GAULAvionique/Station-au-sol-PCBv2/SAS_PCBv2/SAS_PCBv2.kicad_pcb

## KiCad design SAS_PCBv2/SAS_PCBv2.kicad_pcb (2026-07-17)

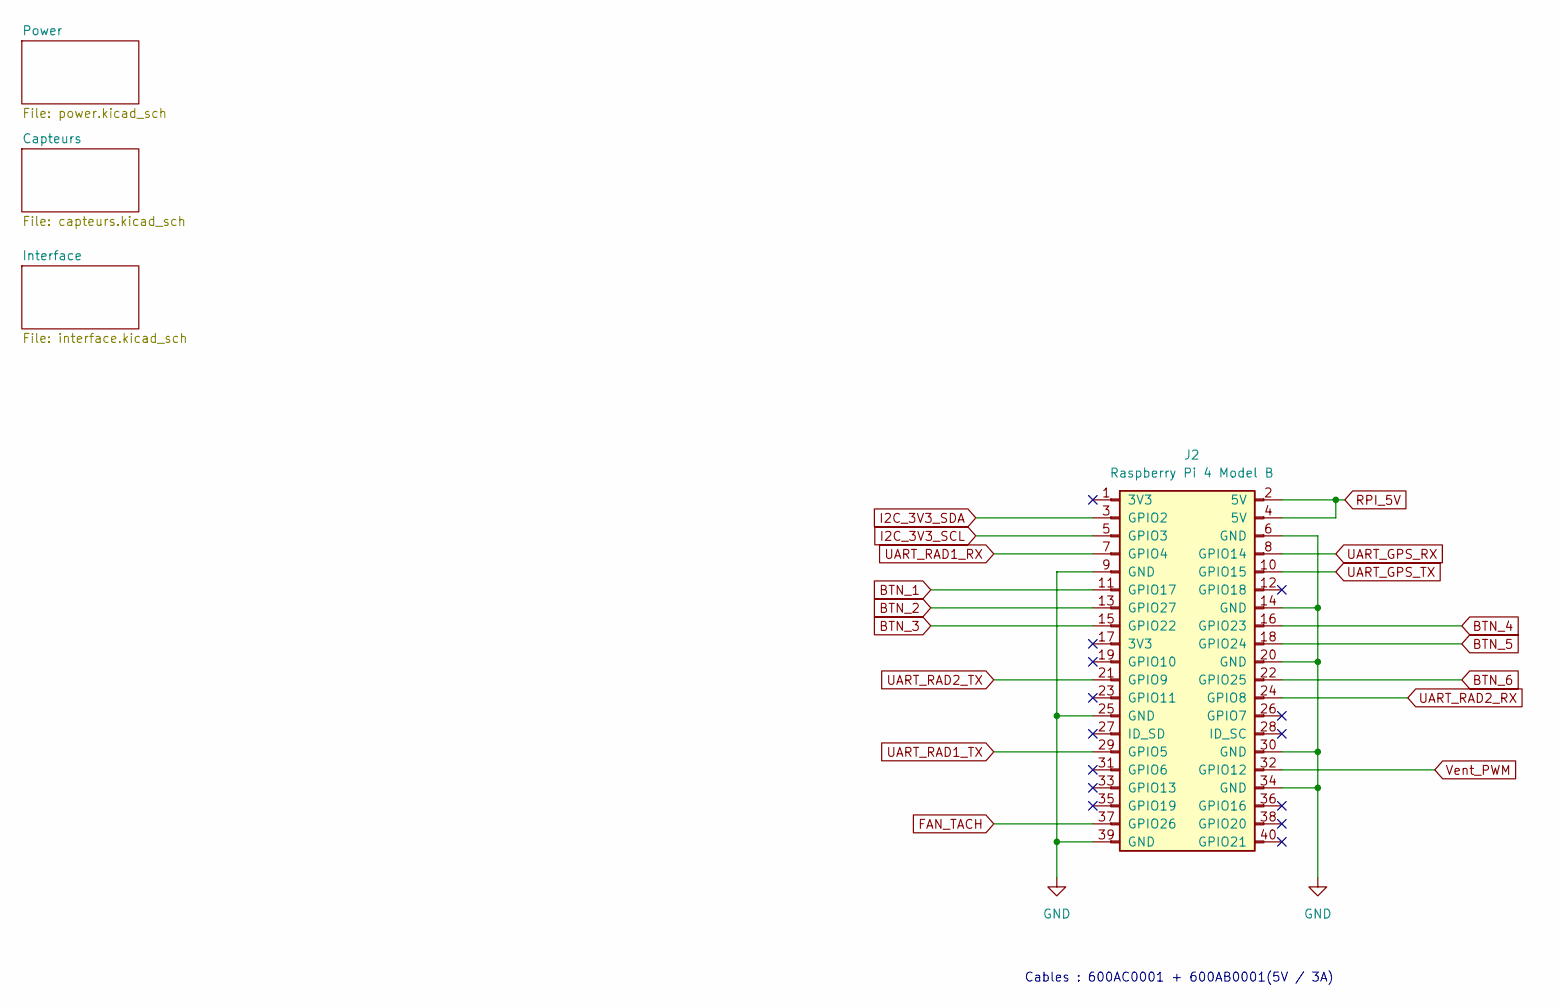
[picture p1: schematic SAS_PCBv2.kicad_sch]

Parts:
J2: Raspberry Pi 4 Model B; PinSocket_2x20_P2.54mm_Vertical

Connections:
BTN_1: J2.11 (GPIO17); also elsewhere on the board
BTN_2: J2.13 (GPIO27); also elsewhere on the board
BTN_3: J2.15 (GPIO22); also elsewhere on the board
BTN_4: J2.16 (GPIO23); also elsewhere on the board
BTN_5: J2.18 (GPIO24); also elsewhere on the board
BTN_6: J2.22 (GPIO25); also elsewhere on the board
FAN_TACH: J2.37 (GPIO26); also elsewhere on the board
GND: J2.6 (GND), J2.9 (GND), J2.14 (GND), J2.20 (GND), J2.25 (GND), J2.30 (GND), J2.34 (GND), J2.39 (GND); also elsewhere on the board
I2C_3V3_SCL: J2.5 (GPIO3); also elsewhere on the board
I2C_3V3_SDA: J2.3 (GPIO2); also elsewhere on the board
RPI_5V: J2.2 (5V), J2.4 (5V); also elsewhere on the board
UART_GPS_RX: J2.8 (GPIO14); also elsewhere on the board
UART_GPS_TX: J2.10 (GPIO15); also elsewhere on the board
UART_RAD1_RX: J2.7 (GPIO4); also elsewhere on the board
UART_RAD1_TX: J2.29 (GPIO5); also elsewhere on the board
UART_RAD2_RX: J2.24 (GPIO8); also elsewhere on the board
UART_RAD2_TX: J2.21 (GPIO9); also elsewhere on the board
Vent_PWM: J2.32 (GPIO12); also elsewhere on the board

Notes on the sheet:
Cables : 600AC0001 + 600AB0001(5V / 3A)

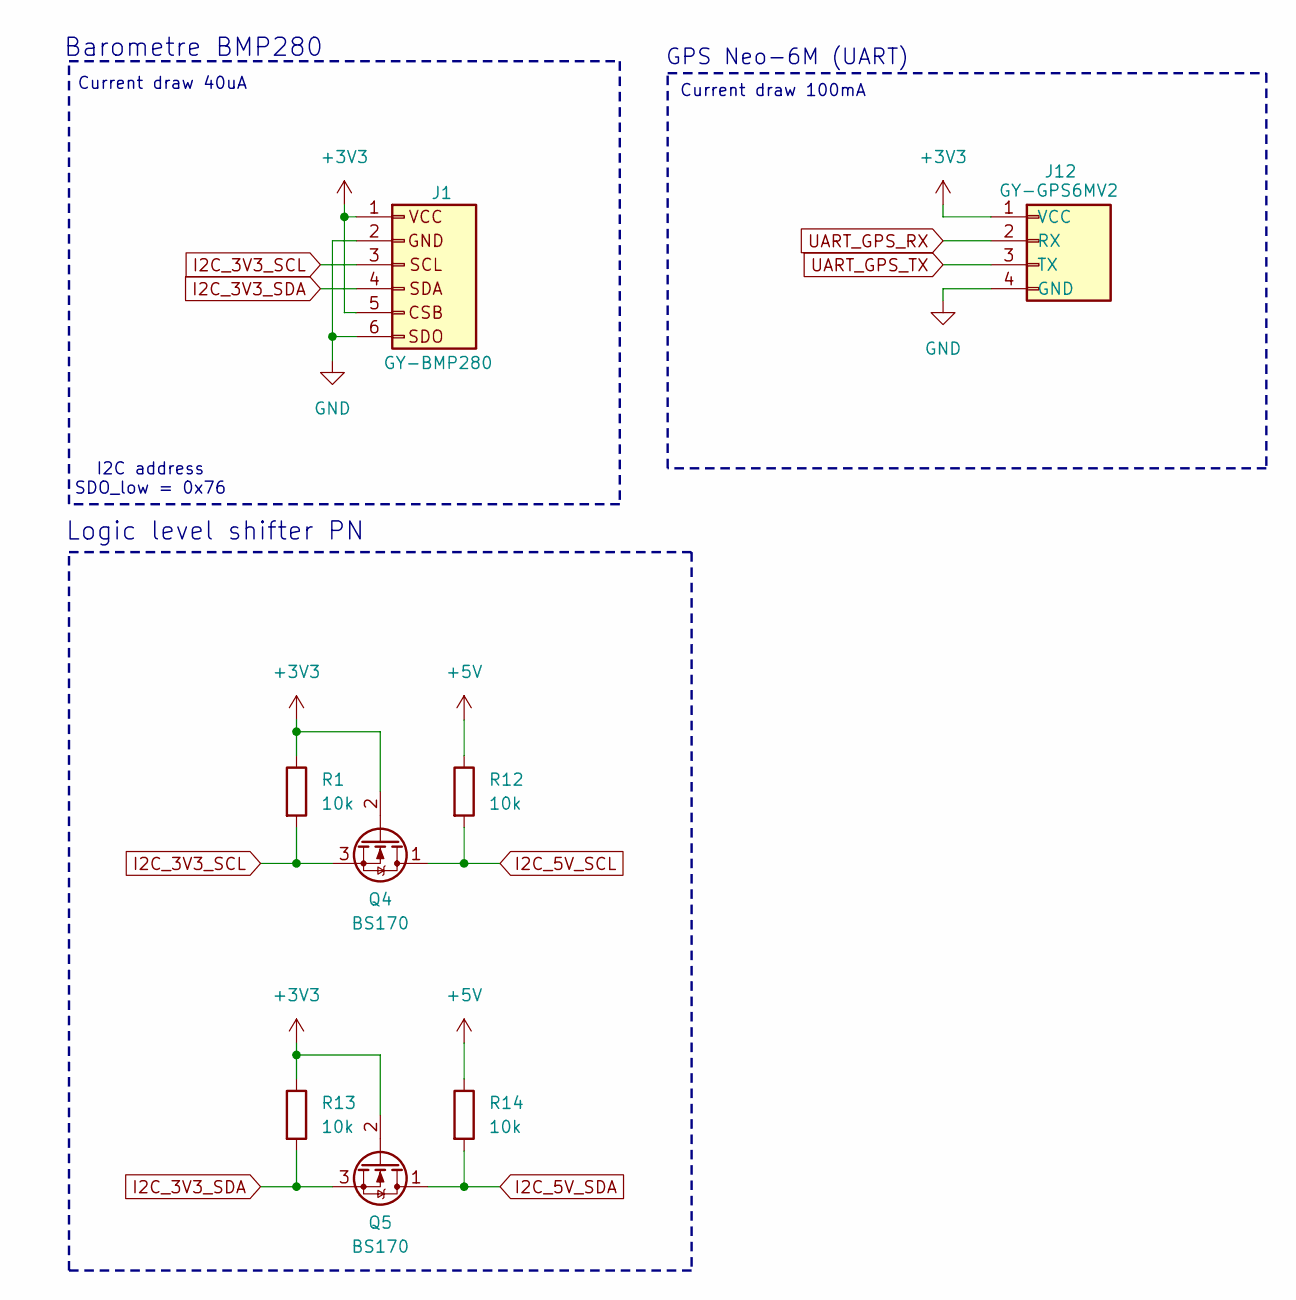
[picture p2: schematic capteurs.kicad_sch]

Parts:
J1: GY-BMP280; PinHeader_1x06_P2.54mm_Vertical
J12: GY-GPS6MV2; PinHeader_1x04_P2.54mm_Vertical
Q4, Q5: BS170; TO-92_Inline
R1, R12, R13, R14: 10k; R_Axial_DIN0207_L6.3mm_D2.5mm_P10.16mm_Horizontal; Digikey MFR-25FRF52-10K

Connections:
+3V3: J1.1 (Vcc), J1.5, J12.1 (VCC), Q4.2 (G), Q5.2 (G), R1.1, R13.1; also elsewhere on the board
+5V: R12.1, R14.1; also elsewhere on the board
GND: J1.2, J1.6, J12.4 (GND); also elsewhere on the board
I2C_3V3_SCL: J1.3, Q4.3 (S), R1.2; also elsewhere on the board
I2C_3V3_SDA: J1.4, Q5.3 (S), R13.2; also elsewhere on the board
I2C_5V_SCL: Q4.1 (D), R12.2; also elsewhere on the board
I2C_5V_SDA: Q5.1 (D), R14.2; also elsewhere on the board
UART_GPS_RX: J12.2 (RX); also elsewhere on the board
UART_GPS_TX: J12.3 (TX); also elsewhere on the board

Notes on the sheet:
Current draw 40uA
Logic level shifter PN
GPS Neo-6M (UART)
I2C address SDO_low = 0x76
Barometre BMP280
Current draw 100mA

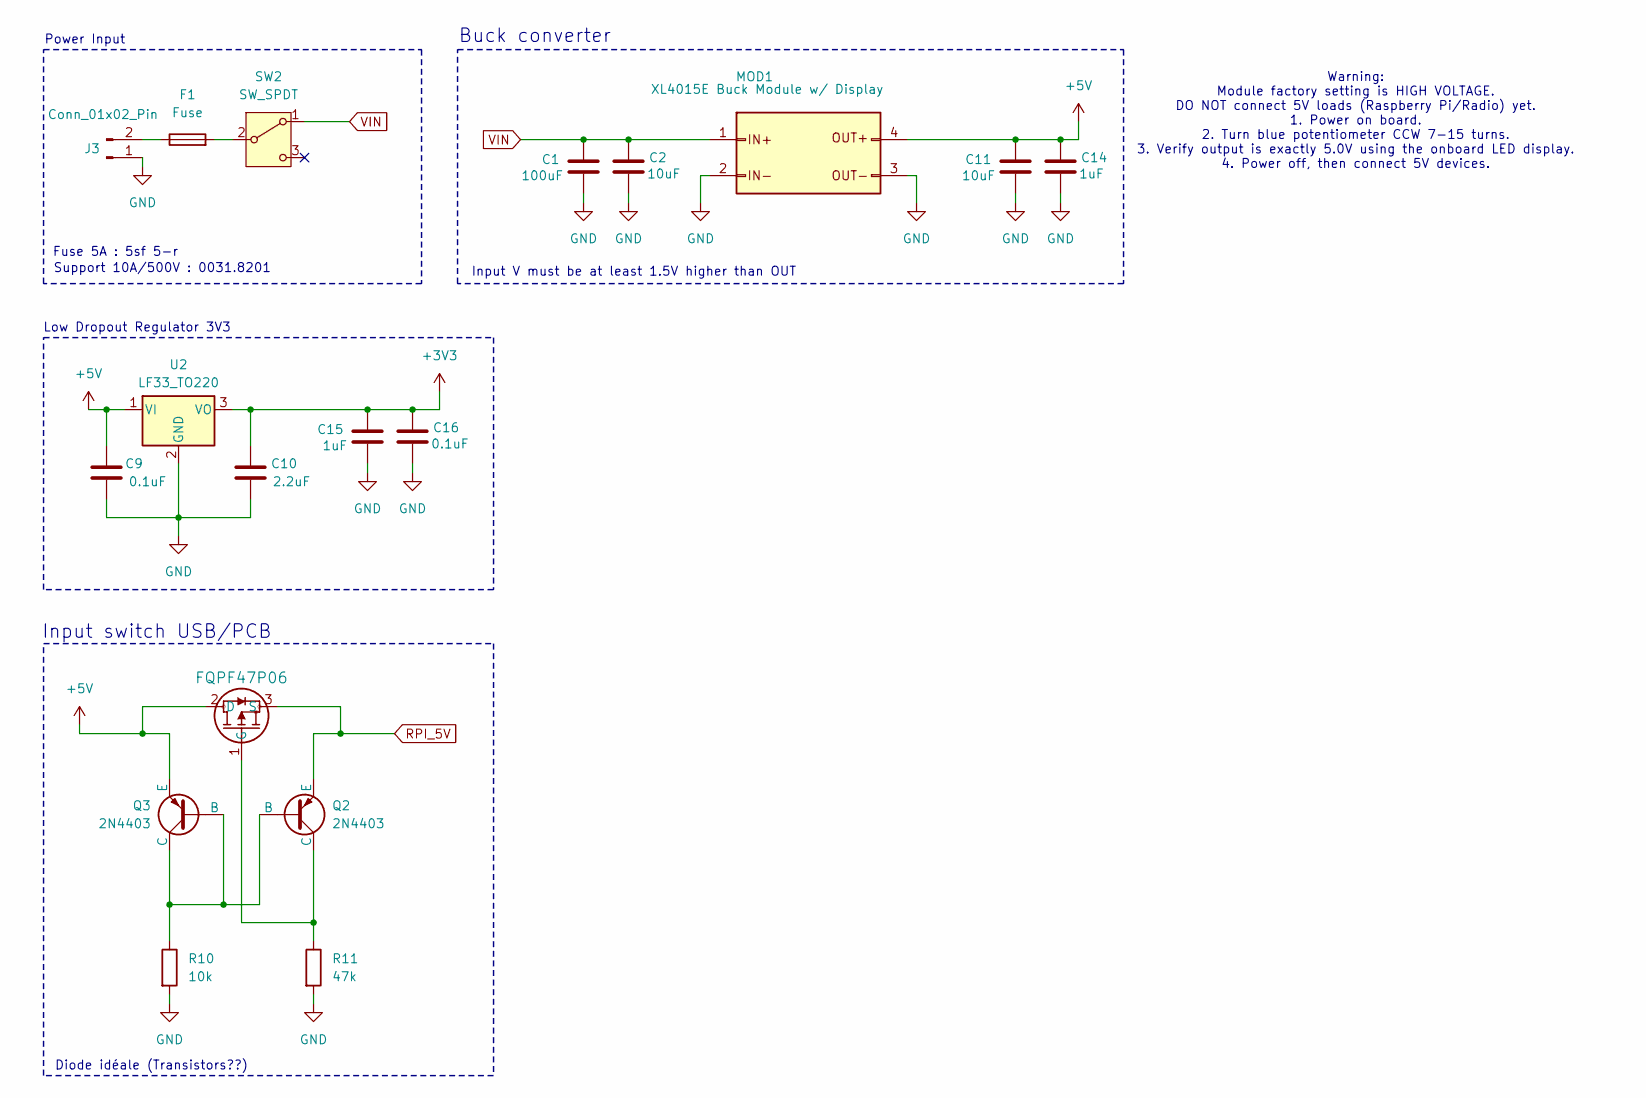
[picture p3: schematic power.kicad_sch]

Parts:
C1: 100uF; CAP_RR71_NIC
C2, C11: 10uF; CP_Radial_D5.0mm_P2.00mm; Digikey 1189-2322-ND
C9, C16: 0.1uF; CAP_C320_KEM
C10: 2.2uF; CAP_FG14_TDK
C14, C15: 1uF; CP_Radial_D5.0mm_P2.00mm
F1: Fuse; Fuseholder_Cylinder-5x20mm_Schurter_0031_8201_Horizontal_Op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
J3: Conn_01x02_Pin; AMASS_XT30U-M_1x02_P5.0mm_Vertical
MOD1: XL4015E Buck Module w/ Display; XL4015E_Buck_Module_68x38mm(1)
MOSFET1: FQPF47P06; PMOS_FQP_ONS
Q2, Q3: 2N4403; PBIP_2N4403_DIO
R10: 10k; R_Axial_DIN0207_L6.3mm_D2.5mm_P10.16mm_Horizontal; Digikey MFR-25FRF52-10K
R11: 47k; R_Axial_DIN0207_L6.3mm_D2.5mm_P10.16mm_Horizontal; Digikey MFR-25FRF52-47K
SW2: SW_SPDT; SW_ANT1_CRS
U2: LF33_TO220; TO-220-3_Vertical

Connections:
+3V3: C10.1, C15.1, C16.1, U2.3 (VO); also elsewhere on the board
+5V: C9.1, C11.1, C14.1, MOD1.4 (OUT+), MOSFET1.2 (D), Q3.1 (E), U2.1 (VI); also elsewhere on the board
GND: C1.2, C2.2, C9.2, C10.2, C11.2, C14.2, C15.2, C16.2, J3.1, MOD1.2 (IN-), MOD1.3 (OUT-), R10.2, R11.2, U2.2 (GND); also elsewhere on the board
unnamed: F1.1, J3.2
unnamed: MOSFET1.1 (G), Q2.3 (C), R11.1
unnamed: Q2.2 (B), Q3.2 (B), Q3.3 (C), R10.1
unnamed: F1.2, SW2.2 (B)
RPI_5V: MOSFET1.3 (S), Q2.1 (E); also elsewhere on the board
VIN: C1.1, C2.1, MOD1.1 (IN+), SW2.1 (A)

Notes on the sheet:
Fuse 5A : 5sf 5-r
Low Dropout Regulator 3V3
Support 10A/500V : 0031.8201
Diode idéale (Transistors??)
Input switch USB/PCB
Input V must be at least 1.5V higher than OUT
Power Input
Buck converter
Warning: Module factory setting is HIGH VOLTAGE. DO NOT connect 5V loads (Raspberry Pi/Radio) yet. 1. Power on board. 2. Turn blue potentiometer CCW 7-15 turns. 3. Verify output is exactly 5.0V using the onboard LED display. 4. Power off, then connect 5V devices.

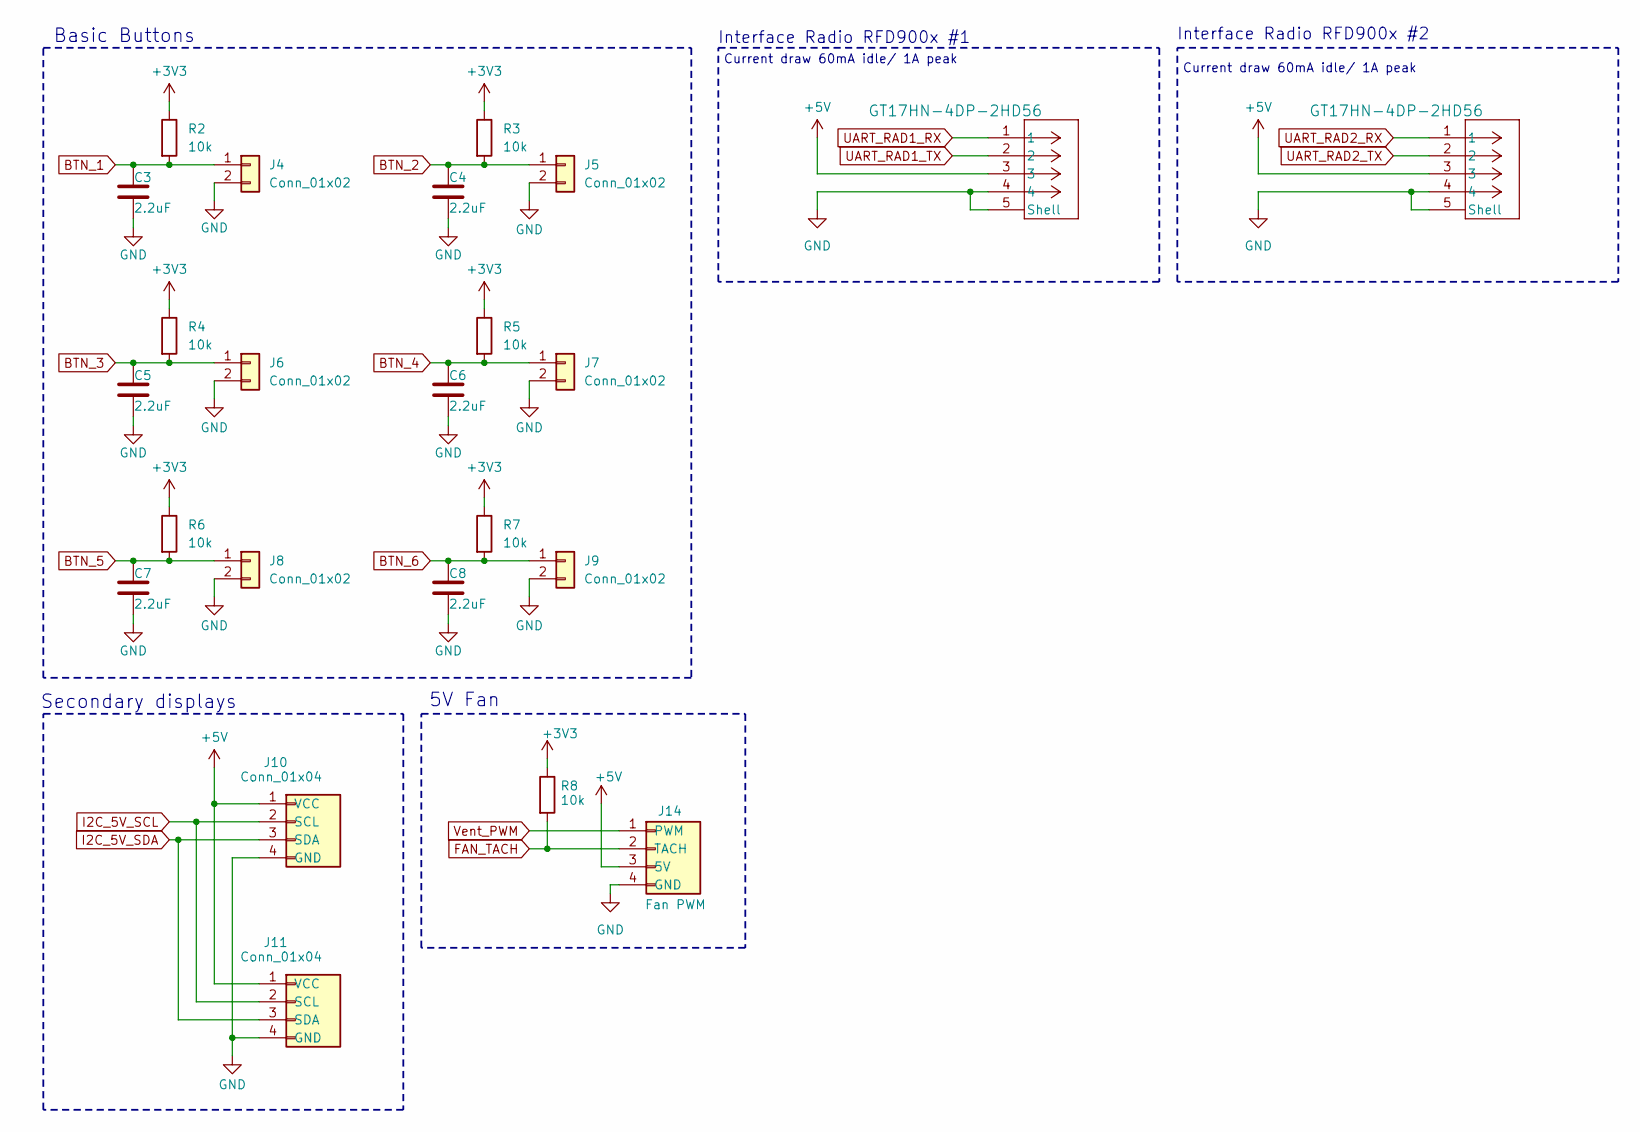
[picture p4: schematic interface.kicad_sch]

Parts:
C3, C4, C5, C6, C7, C8: 2.2uF; CAP_FG14_TDK
J4, J5, J6, J7, J8, J9: Conn_01x02; PinHeader_1x02_P2.54mm_Vertical
J10, J11: Conn_01x04; PinHeader_1x04_P2.54mm_Vertical
J14: Fan PWM; PinHeader_1x04_P2.54mm_Vertical
J16, J17: GT17HN-4DP-2HD56; CONN4_GT17HN_HIR; Manufacturer_Part_Number GT17HN-4DP-2H(D)(56); DigiKey_Part_Number 26-GT17HN-4DP-2H(D)(56)-ND
R2, R3, R4, R5, R6, R7, R8: 10k; R_Axial_DIN0207_L6.3mm_D2.5mm_P10.16mm_Horizontal; Digikey MFR-25FRF52-10K

Connections:
+3V3: R2.1, R3.1, R4.1, R5.1, R6.1, R7.1, R8.1; also elsewhere on the board
+5V: J10.1 (VCC), J11.1 (VCC), J14.3 (5V), J16.3, J17.3; also elsewhere on the board
BTN_1: C3.1, J4.1, R2.2; also elsewhere on the board
BTN_2: C4.1, J5.1, R3.2; also elsewhere on the board
BTN_3: C5.1, J6.1, R4.2; also elsewhere on the board
BTN_4: C6.1, J7.1, R5.2; also elsewhere on the board
BTN_5: C7.1, J8.1, R6.2; also elsewhere on the board
BTN_6: C8.1, J9.1, R7.2; also elsewhere on the board
FAN_TACH: J14.2 (TACH), R8.2; also elsewhere on the board
GND: C3.2, C4.2, C5.2, C6.2, C7.2, C8.2, J4.2, J5.2, J6.2, J7.2, J8.2, J9.2, J10.4 (GND), J11.4 (GND), J14.4 (GND), J16.4, J16.5 (Shell), J16.6 (Shell), J16.7 (Shell), J16.8 (Shell), J17.4, J17.5 (Shell), J17.6 (Shell), J17.7 (Shell), J17.8 (Shell); also elsewhere on the board
I2C_5V_SCL: J10.2 (SCL), J11.2 (SCL); also elsewhere on the board
I2C_5V_SDA: J10.3 (SDA), J11.3 (SDA); also elsewhere on the board
UART_RAD1_RX: J16.1; also elsewhere on the board
UART_RAD1_TX: J16.2; also elsewhere on the board
UART_RAD2_RX: J17.1; also elsewhere on the board
UART_RAD2_TX: J17.2; also elsewhere on the board
Vent_PWM: J14.1 (PWM); also elsewhere on the board

Notes on the sheet:
5V Fan
Current draw 60mA idle/ 1A peak
Secondary displays
Interface Radio RFD900x #2
Basic Buttons
Interface Radio RFD900x #1

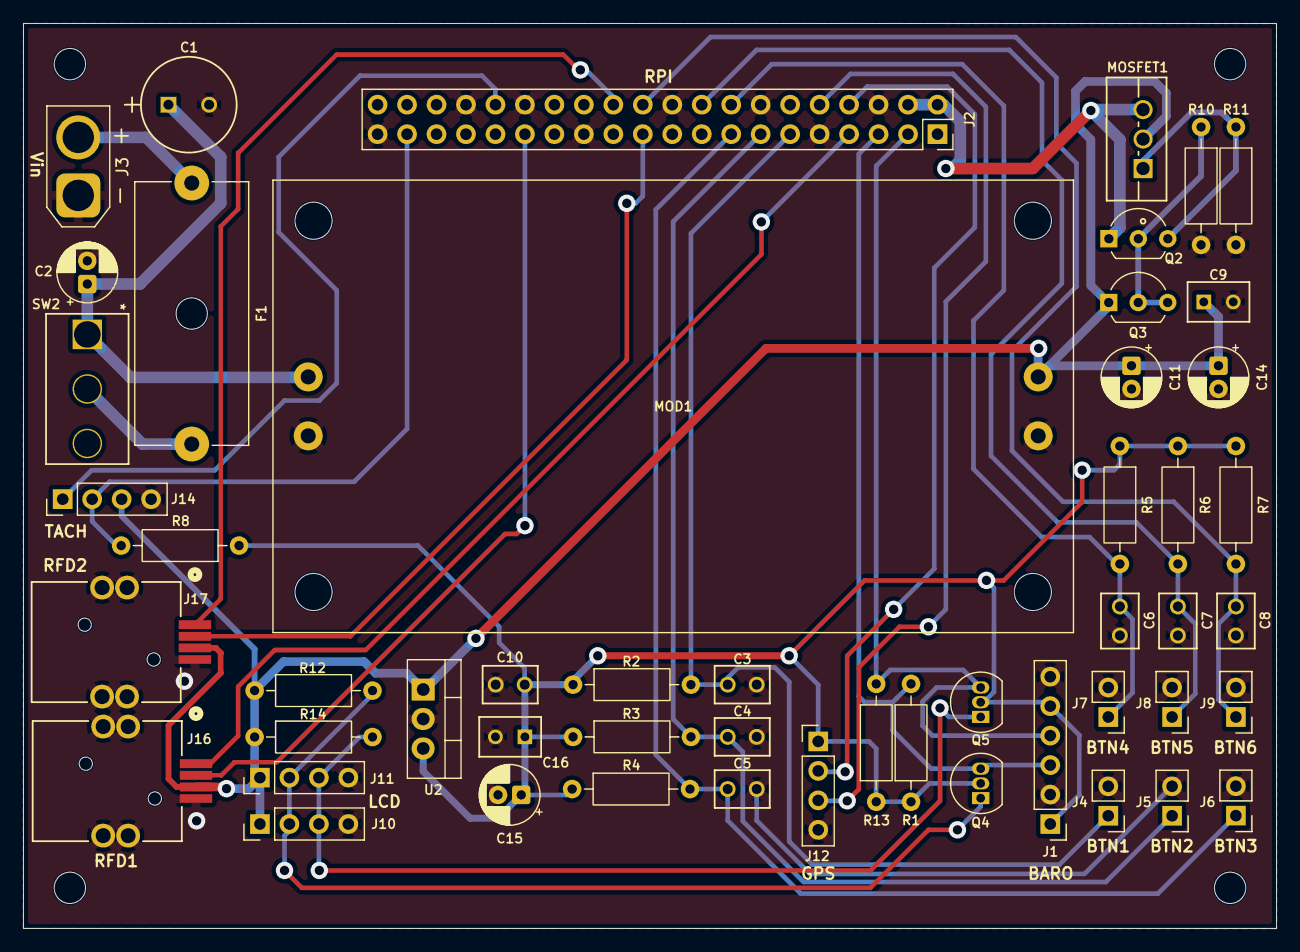
[picture p5: board SAS_PCBv2.kicad_pcb from above]

Board: 2 copper layers, 108.0 x 78.0 mm, 51 parts (0 on the bottom side), 27 nets.
