GAULAvionique/Station-au-sol-PCBv2/(commit log)

2025-10-13 création projet kicad
    [SAS_PCBv2.kicad_pcb, SAS_PCBv2.kicad_sch, capteurs.kicad_sch, interface.kicad_sch, power.kicad_sch]
2025-10-30 Add footprint to create folder
2026-01-10 bmp280 + LogicLevelShifterPN I2C
    [SAS_PCBv2.kicad_sch, capteurs.kicad_sch]
2026-01-21 Power Input and LDO
    [power.kicad_sch]
2026-03-03 Added basic Buttons w/ Rpi connections
    [SAS_PCBv2.kicad_sch, interface.kicad_sch]
2026-03-03 Added secondary displays, completed LDO 3V3
    [SAS_PCBv2.kicad_sch, interface.kicad_sch, power.kicad_sch]
2026-03-04 Radio et GPS fait selon les datasheets normalement
    [SAS_PCBv2.kicad_sch, capteurs.kicad_sch, interface.kicad_sch]
2026-03-05 debut buck
    [power.kicad_sch]
2026-04-16 schematic sans error et le debut de pcb
    [SAS_PCBv2.kicad_pcb, SAS_PCBv2.kicad_sch, capteurs.kicad_sch, interface.kicad_sch, power.kicad_sch]
2026-05-07 Correction UART5 -> UART3, ajout d'un ventilateur 12V PWM
    [SAS_PCBv2.kicad_sch, interface.kicad_sch]
2026-05-08 Switch USB/PCB, connections Power, spam condensateurs, resistance pull-up
    [SAS_PCBv2.kicad_sch, capteurs.kicad_sch, interface.kicad_sch, power.kicad_sch]
2026-05-12 LDO du service, Logic level shifter custom
    [SAS_PCBv2.kicad_sch, capteurs.kicad_sch, interface.kicad_sch, power.kicad_sch]
2026-05-12 Amélioration des modèles Rpi et page power, switch PCB/USB fonctionnelle
    [SAS_PCBv2.kicad_sch, power.kicad_sch]
2026-05-13 Identification des transistors, footprint BMP280 et GPS Neo-6M, correction du fan PWM
    [SAS_PCBv2.kicad_sch, capteurs.kicad_sch, interface.kicad_sch, power.kicad_sch]
2026-05-28 Ajout du connecteur spécial pour les radios, insertion des footprints dans le PCB, fin du schéma
    [SAS_PCBv2.kicad_pcb, SAS_PCBv2.kicad_sch, capteurs.kicad_sch, interface.kicad_sch, power.kicad_sch]
2026-05-28 Composantes placees sur le PCB
    [SAS_PCBv2.kicad_pcb]
2026-05-29 PCB prêt à être routé
    [SAS_PCBv2.kicad_pcb]
2026-07-06 Finalisation du PCB : routage complet, découpe du contour, DRC?
    [SAS_PCBv2-B_Cu.gbr, SAS_PCBv2-B_Mask.gbr, SAS_PCBv2-B_Paste.gbr, SAS_PCBv2-B_Silkscreen.gbr, SAS_PCBv2-Edge_Cuts.gbr, SAS_PCBv2-F_Cu.gbr, SAS_PCBv2-F_Mask.gbr, SAS_PCBv2-F_Paste.gbr]
2026-07-08 Rerouting des traces débutant du top layer
    [SAS_PCBv2.kicad_pcb]
2026-07-10 Routage des connexions du côté de la soudure et ajout d'un plan de masse
    [SAS_PCBv2-B_Cu.gbr, SAS_PCBv2-B_Mask.gbr, SAS_PCBv2-B_Paste.gbr, SAS_PCBv2-B_Silkscreen.gbr, SAS_PCBv2-Edge_Cuts.gbr, SAS_PCBv2-F_Cu.gbr, SAS_PCBv2-F_Mask.gbr, SAS_PCBv2-F_Paste.gbr]
2026-07-15 Fix footprints, widen power traces, route RPi cables, fix transistor pinout
    [SAS_PCBv2-B_Cu.gbr, SAS_PCBv2-B_Mask.gbr, SAS_PCBv2-B_Paste.gbr, SAS_PCBv2-B_Silkscreen.gbr, SAS_PCBv2-Edge_Cuts.gbr, SAS_PCBv2-F_Cu.gbr, SAS_PCBv2-F_Mask.gbr, SAS_PCBv2-F_Paste.gbr]
2026-07-16 ajout Logo GAUL
    [SAS_PCBv2.kicad_pcb]
2026-07-17 finition et fabrication
    [SAS_PCBv2.kicad_pcb, power.kicad_sch]
2026-07-17 Correction width Rpi 5V
    [SAS_PCBv2-B_Cu.gbr, SAS_PCBv2-B_Mask.gbr, SAS_PCBv2-B_Silkscreen.gbr, SAS_PCBv2-Edge_Cuts.gbr, SAS_PCBv2-F_Cu.gbr, SAS_PCBv2-F_Mask.gbr, SAS_PCBv2-F_Paste.gbr, SAS_PCBv2-F_Silkscreen.gbr]
